hyperion11/CruiseToyotaPradoStm32/README.md

# CruiseToyotaPradoStm32
Cruise control for toyota prado 95
Круиз контроль для TLC Prado 95
