hyperion11/CruiseToyotaPradoStm32/Clip2net_190120225030.png

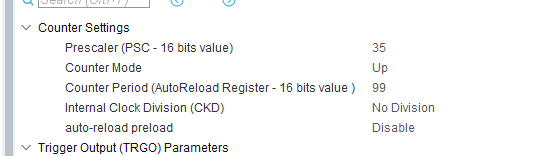
Clip2net_190120225030.png
