hyperion11/CruiseToyotaPradoStm32/bluepill_version_pcb/sch0.1.pdf

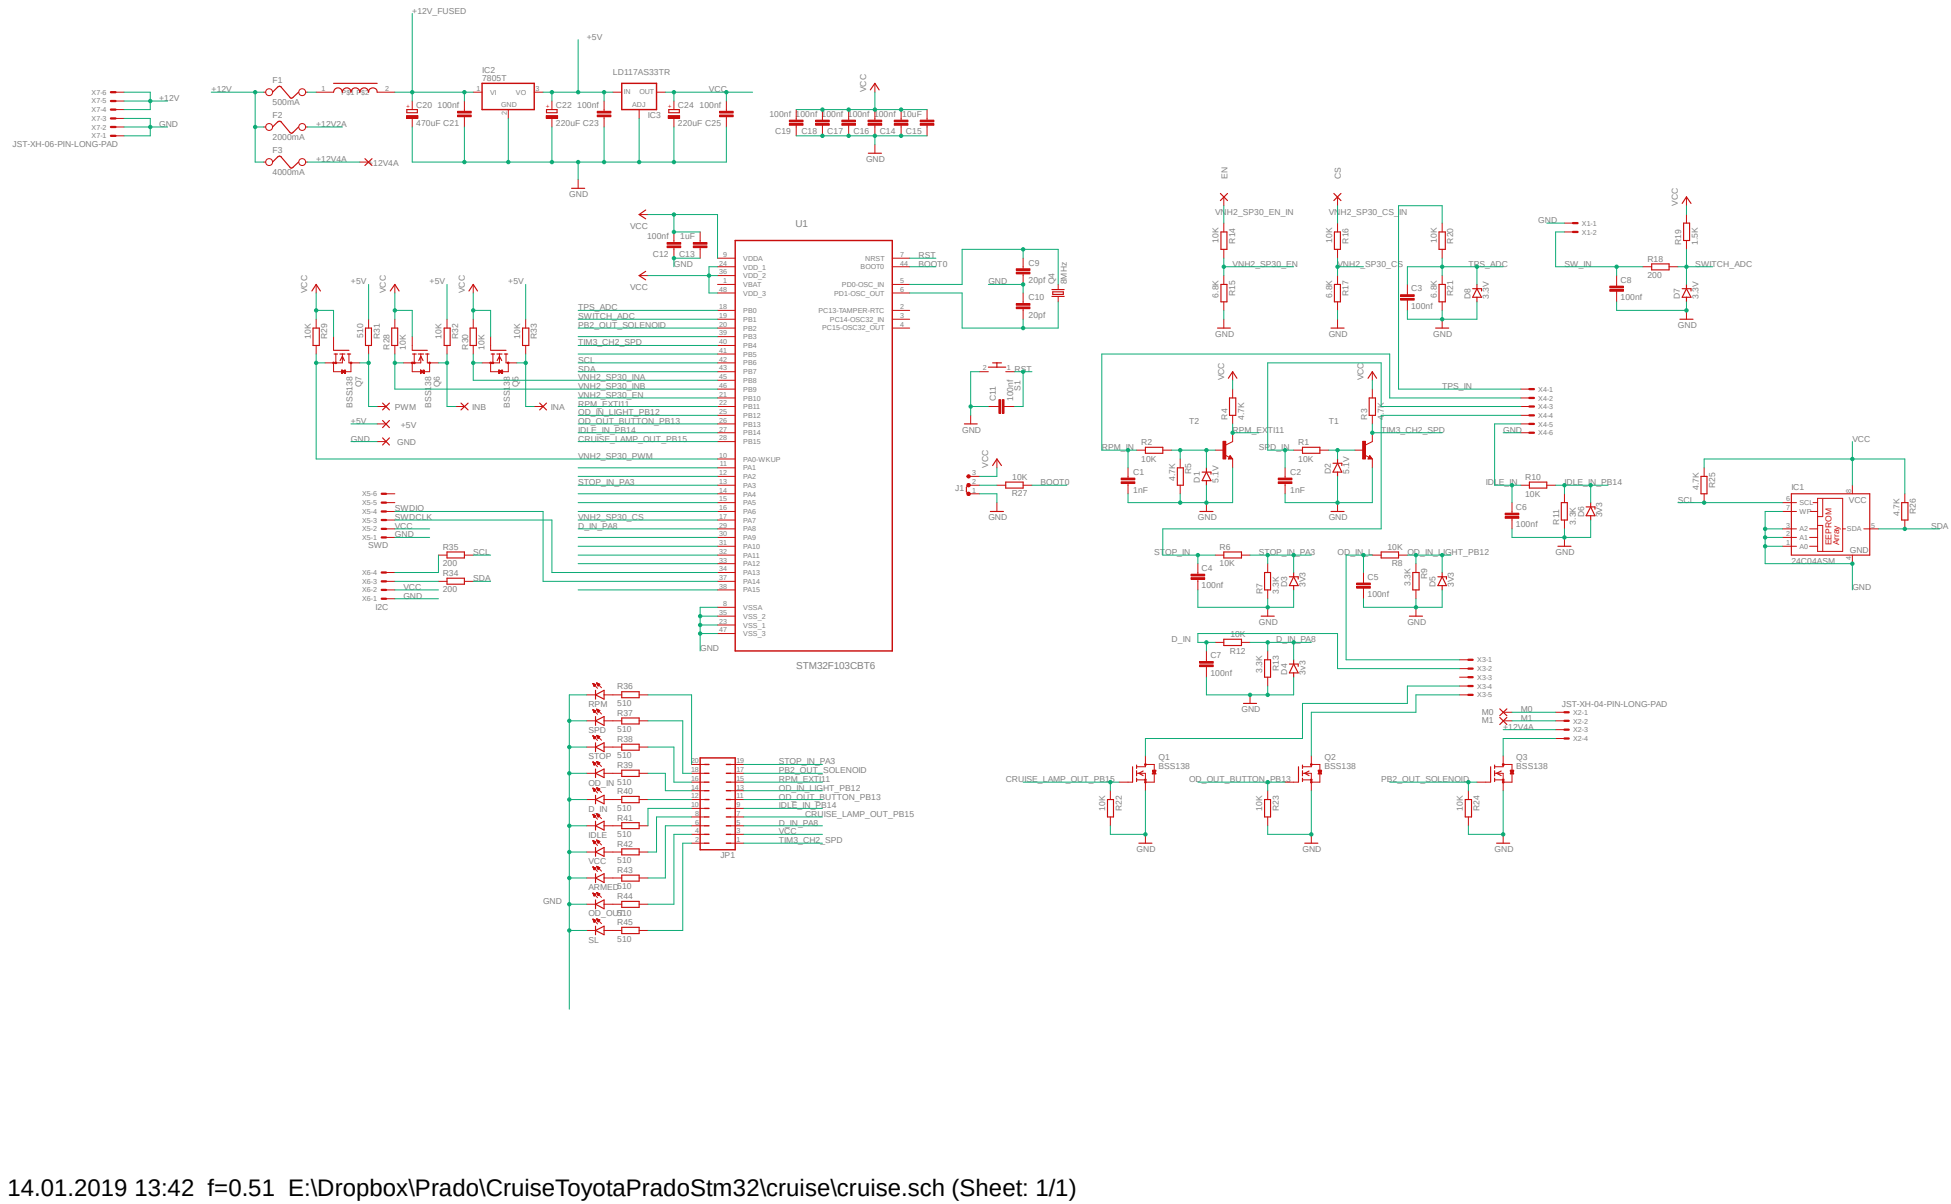
[picture p2: page 1]

JST-XH-06-PIN-LONG-PAD

14.01.2019 13:42 f=0.51 E:\Dropbox\Prado\CruiseToyotaPradoStm32\cruise\cruise.sch (Sheet: 1/1)
