hyperion11/CruiseToyotaPradoStm32/core_version_pcb/cruise.brd

## EAGLE design core_version_pcb/cruise.brd (2019-02-28)

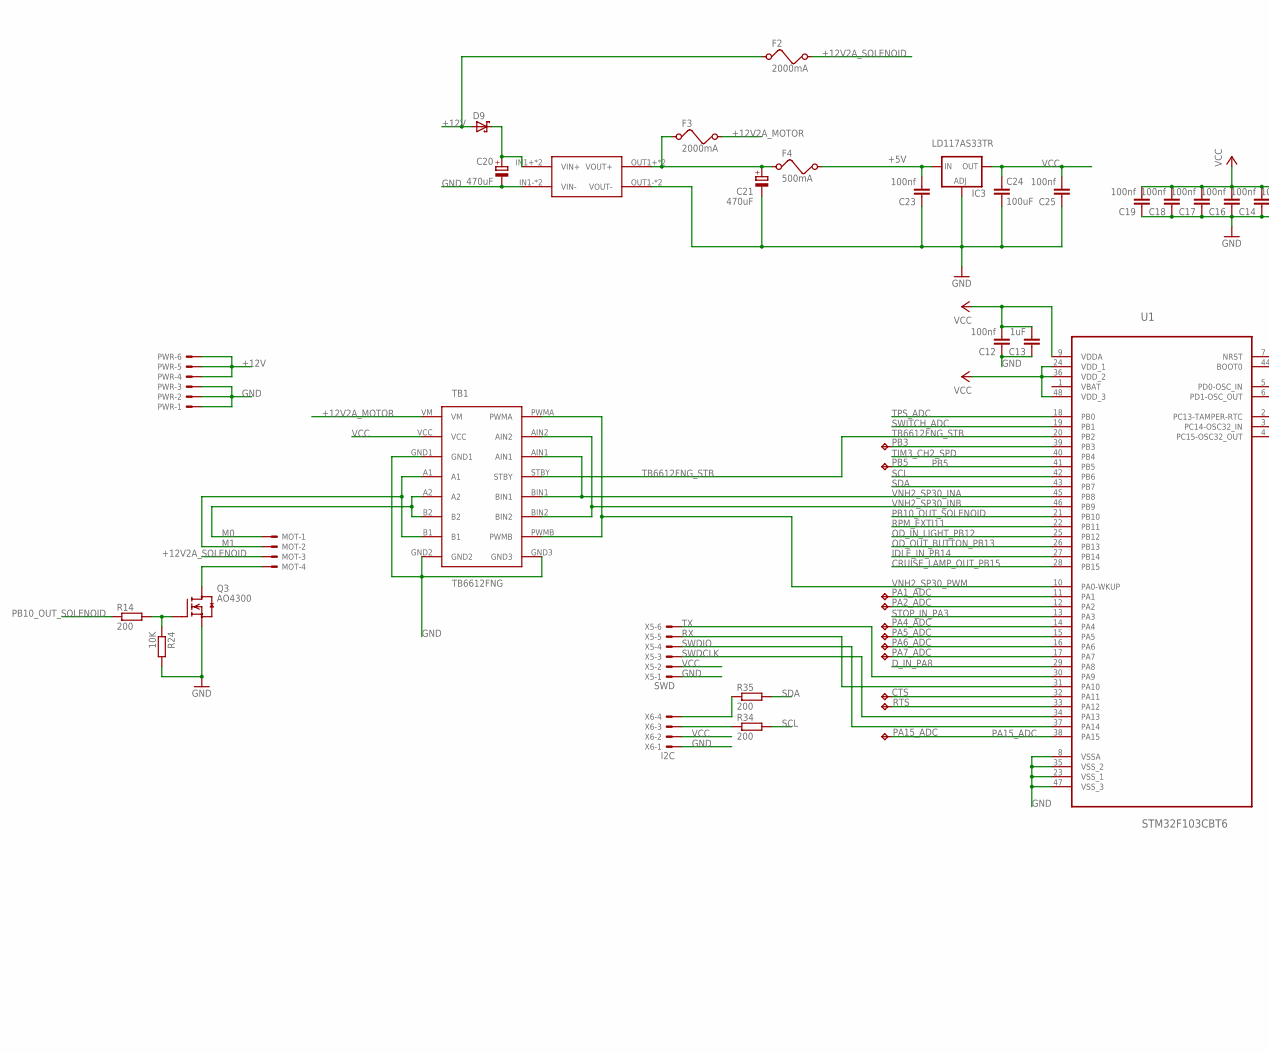
[picture p3: schematic cruise.sch, part in row 1, column 1]

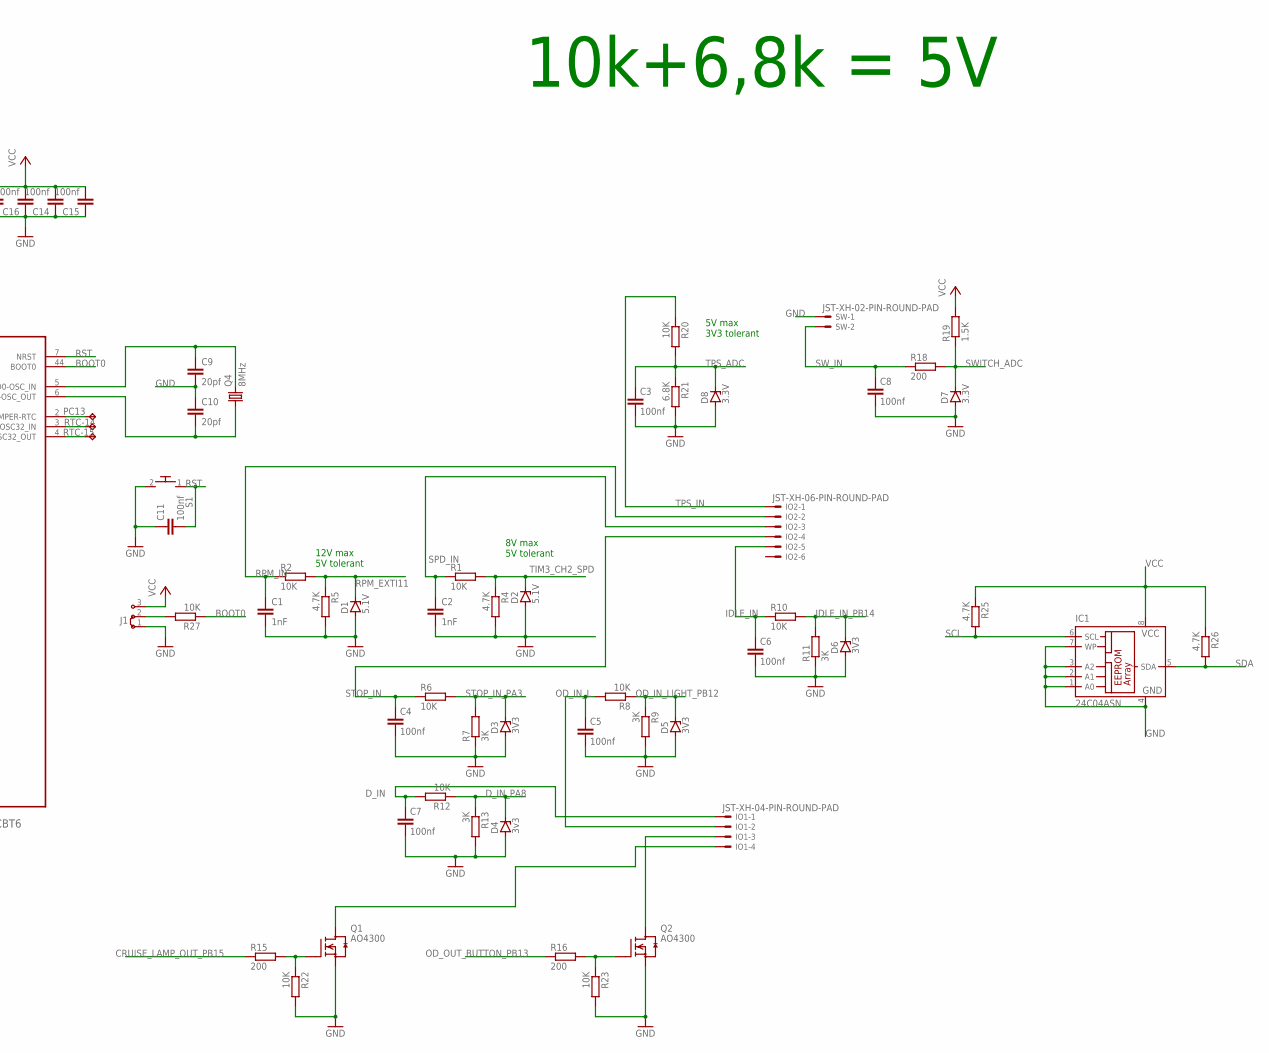
[picture p4: schematic cruise.sch, part in row 1, column 2]

Parts:
C1, C2: 1nF; C0805K
C3, C4, C5, C6, C7, C8, C11, C12, C14, C15, C16, C17, C18, C19: 100nf; C0805K
C9, C10: 20pf; C0603
C13: 1uF; C0805K
C20, C21: 470uF; PANASONIC_G
C23, C25: 100nf; C0805
C24: 100uF; C1210
CTS: TPTP09R; TP09R
D1, D2: 5.1V; SOD80C
D3, D5, D6: 3V3; SOD80C
D4: 3v3; SOD80C
D7, D8: 3.3V; SOD80C
D9: SCHOTTKY-DIODESMC; DIODE_SMC
F2, F3: 2000mA; 1206
F4: 500mA; 1206
IC1: 24C04ASN; SO-08
IC3: LD117AS33TR; SOT223
IO1: JST-XH-04-PIN-ROUND-PAD; JST-XH-04-PACKAGE-ROUND-PAD
IO2: JST-XH-06-PIN-ROUND-PAD; JST-XH-06-PACKAGE-ROUND-PAD
J1: J2X2MM; 04C
MOT: JST-XH-04-PIN-LONG-PAD; JST-XH-04-PACKAGE-LONG-PAD
PA1_ADC, PA2_ADC, PA4_ADC, PA5_ADC, PA6_ADC, PA7_ADC, PA15_ADC: TPTP09R; TP09R
PB3, PB5: TPTP09R; TP09R
PC13: TPTP09R; TP09R
PWR: JST-XH-06-PIN-LONG-PAD; JST-XH-06-PACKAGE-LONG-PAD
Q1, Q2, Q3: AO4300; SOT23
Q4: 8MHz; 5.0X3.2_2
R1, R2, R6, R8, R10, R12, R20, R22, R23, R24, R27: 10K; R0805
R4, R5, R25, R26: 4.7K; R0805
R7, R9, R11, R13: 3K; R0805
R14, R15, R16, R18, R34, R35: 200; R0805
R19: 1.5K; R0805
R21: 6.8K; R0805
RTC-14, RTC-15: TPTP09R; TP09R
RTS: TPTP09R; TP09R
S1: RESET_BUTTON; EVQ-PJU05K
SW: JST-XH-02-PIN-ROUND-PAD; JST-XH-02-PACKAGE-ROUND-PAD
TB1: TB6612FNG
U1: STM32F103CBT6; QFP50P900X900X160-48N
U$6: MP1584; DC-BRICK
X5: SWD; JST-XH-06-PACKAGE-ROUND-PAD
X6: I2C; JST-XH-04-PACKAGE-ROUND-PAD

Connections:
+5V: C23.2, F4.2, IC3.3 (IN)
+12V: D9.A (C), F2.1, PWR.4, PWR.5, PWR.6
+12V2A_MOTOR: F3.2, TB1.VM
+12V2A_SOLENOID: F2.2, MOT.3
BOOT0: R27.1, U1.44 (BOOT0)
CRUISE_LAMP_OUT_PB15: R15.1, U1.28 (PB15)
D_IN: C7.1, IO1.1, R12.2
D_IN_PA8: D4.C, R12.1, R13.1, U1.29 (PA8)
GND: C1.2, C2.2, C3.2, C4.2, C5.2, C6.2, C7.2, C8.2, C9.2, C10.1, C12.1, C13.1, C14.1, C15.1, C16.1, C17.1, C18.1, C19.1, C20.-, C21.-, C23.1, C24.2, C25.1, D1.A, D2.A, D3.A, D4.A, D5.A, D6.A, D7.A, D8.A, IC1.1 (A0), IC1.2 (A1), IC1.3 (A2), IC1.4 (GND), IC1.7 (WP), IC3.1 (ADJ), J1.1, PWR.1, PWR.2, PWR.3, Q1.2 (S), Q2.2 (S), Q3.2 (S), R4.2, R5.2, R7.1, R9.2, R11.1, R13.2, R21.2, R22.2, R23.2, R24.2, SW.1, TB1.GND1, TB1.GND2, TB1.GND3, U1.8 (VSSA), U1.23 (VSS_1), U1.35 (VSS_2), U1.47 (VSS_3), U$6.IN1- (VIN-), U$6.IN2- (VIN-), U$6.OUT1- (VOUT-), U$6.OUT2- (VOUT-), X5.1, X6.1
IDLE_IN: C6.1, IO2.5, R10.1
IDLE_IN_PB14: D6.C, R10.2, R11.2, U1.27 (PB14)
M0: MOT.1, TB1.A2, TB1.B2
M1: MOT.2, TB1.A1, TB1.B1
unnamed: MOT.4, Q3.3 (D)
unnamed: C9.1, Q4.2, U1.5 (PD0-OSC_IN)
unnamed: C10.2, Q4.1, U1.6 (PD1-OSC_OUT)
unnamed: PA7_ADC.TP, U1.17 (PA7)
unnamed: C21.+, F3.1, F4.1, U$6.OUT1+ (VOUT+), U$6.OUT2+ (VOUT+)
unnamed: PB3.TP, U1.39 (PB3)
unnamed: J1.2, R27.2
unnamed: Q3.1 (G), R14.2, R24.1
unnamed: C11.1, S1.2
unnamed: Q1.1 (G), R15.2, R22.1
unnamed: R34.1, X6.3
unnamed: R35.1, X6.4
unnamed: Q2.1 (G), R16.2, R23.1
unnamed: PC13.TP, U1.2 (PC13-TAMPER-RTC)
unnamed: RTC-14.TP, U1.3 (PC14-OSC32_IN)
unnamed: RTC-15.TP, U1.4 (PC15-OSC32_OUT)
unnamed: C20.+, D9.C (A), U$6.IN1+ (VIN+), U$6.IN2+ (VIN+)
unnamed: PA1_ADC.TP, U1.11 (PA1)
unnamed: PA2_ADC.TP, U1.12 (PA2)
unnamed: PA4_ADC.TP, U1.14 (PA4)
unnamed: PA6_ADC.TP, U1.16 (PA6)
unnamed: PA5_ADC.TP, U1.15 (PA5)
unnamed: IO1.4, Q1.3 (D)
unnamed: IO1.3, Q2.3 (D)
unnamed: CTS.TP, U1.32 (PA11)
unnamed: RTS.TP, U1.33 (PA12)
OD_IN_L: C5.1, IO1.2, R8.2
OD_IN_LIGHT_PB12: D5.C, R8.1, R9.1, U1.25 (PB12)
OD_OUT_BUTTON_PB13: R16.1, U1.26 (PB13)
PA15_ADC: PA15_ADC.TP, U1.38 (PA15)
PB5: PB5.TP, U1.41 (PB5)
PB10_OUT_SOLENOID: R14.1, U1.21 (PB10)
RPM_EXTI11: D1.C, R2.2, R5.1, U1.22 (PB11)
RPM_IN: C1.1, IO2.2, R2.1
RST: C11.2, S1.1, U1.7 (NRST)
RX: U1.31 (PA10), X5.5
SCL: IC1.6 (SCL), R25.2, R34.2, U1.42 (PB6)
SDA: IC1.5 (SDA), R26.2, R35.2, U1.43 (PB7)
SPD_IN: C2.1, IO2.3, R1.1
STOP_IN: C4.1, IO2.4, R6.1
STOP_IN_PA3: D3.C, R6.2, R7.2, U1.13 (PA3)
SWDCLK: U1.37 (PA14), X5.4
SWDIO: U1.34 (PA13), X5.3
SWITCH_ADC: D7.C, R18.2, R19.1, U1.19 (PB1)
SW_IN: C8.1, R18.1, SW.2
TB6612FNG_STB: TB1.STBY, U1.20 (PB2)
TIM3_CH2_SPD: D2.C, R1.2, R4.1, U1.40 (PB4)
TPS_ADC: C3.1, D8.C, R20.2, R21.1, U1.18 (PB0)
TPS_IN: IO2.1, R20.1
TX: U1.30 (PA9), X5.6
VCC: C12.2, C13.2, C14.2, C15.2, C16.2, C17.2, C18.2, C19.2, C24.1, C25.2, IC1.8 (VCC), IC3.4 (OUT), J1.3, R19.2, R25.1, R26.1, TB1.VCC, U1.9 (VDDA), U1.24 (VDD_1), U1.36 (VDD_2), U1.48 (VDD_3), X5.2, X6.2
VNH2_SP30_INA: TB1.AIN1, TB1.BIN1, U1.45 (PB8)
VNH2_SP30_INB: TB1.AIN2, TB1.BIN2, U1.46 (PB9)
VNH2_SP30_PWM: TB1.PWMA, TB1.PWMB, U1.10 (PA0-WKUP)

Notes on the sheet:
10k+6,8k = 5V
8V max 5V tolerant
12V max 5V tolerant
5V max 3V3 tolerant

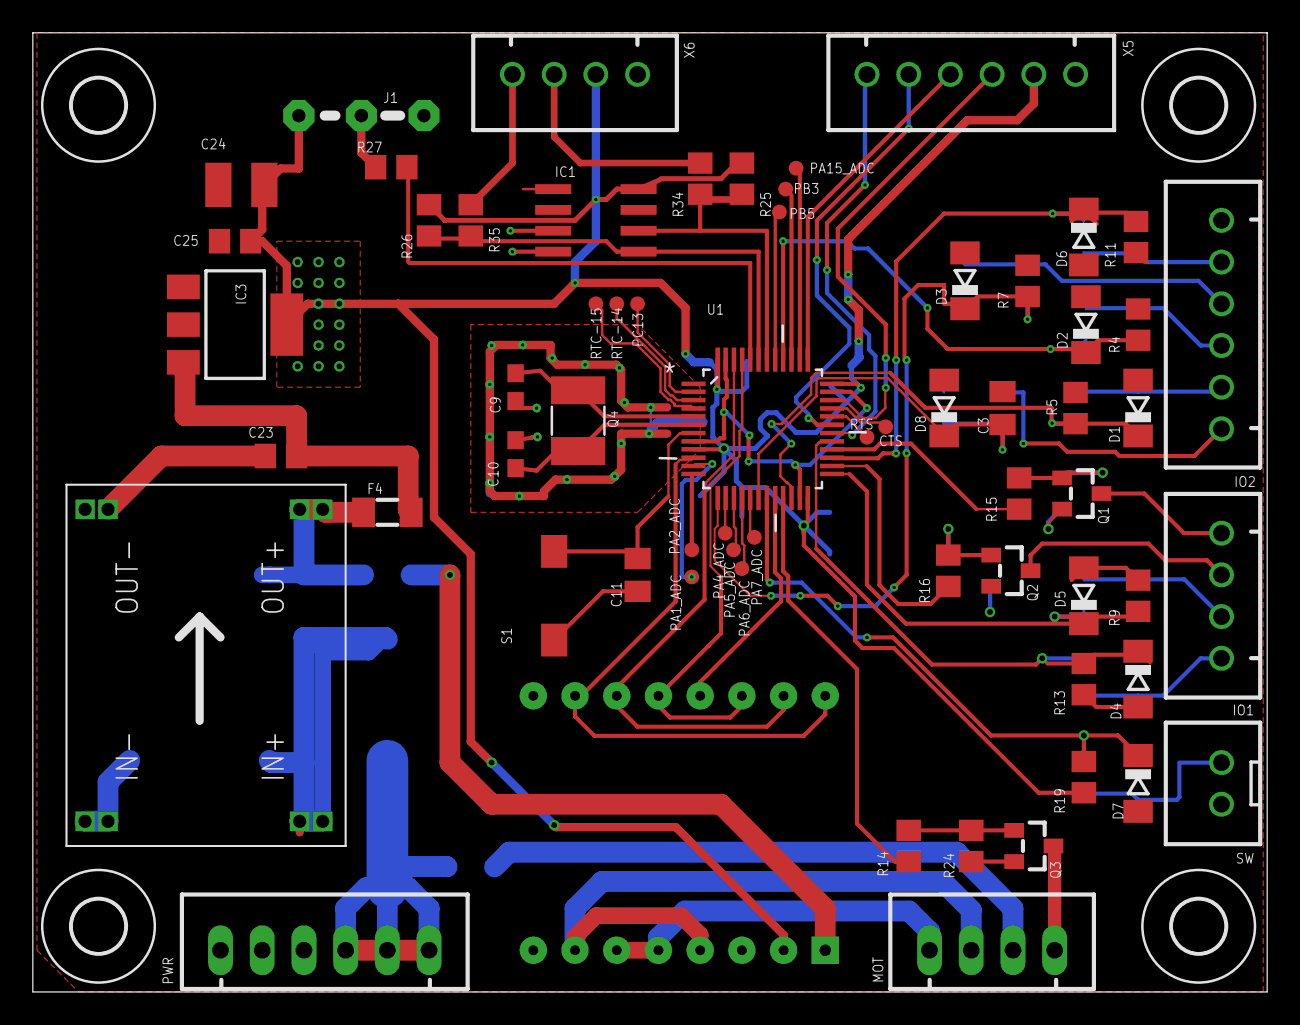
[picture p5: board core_version_pcb/cruise.brd from above]

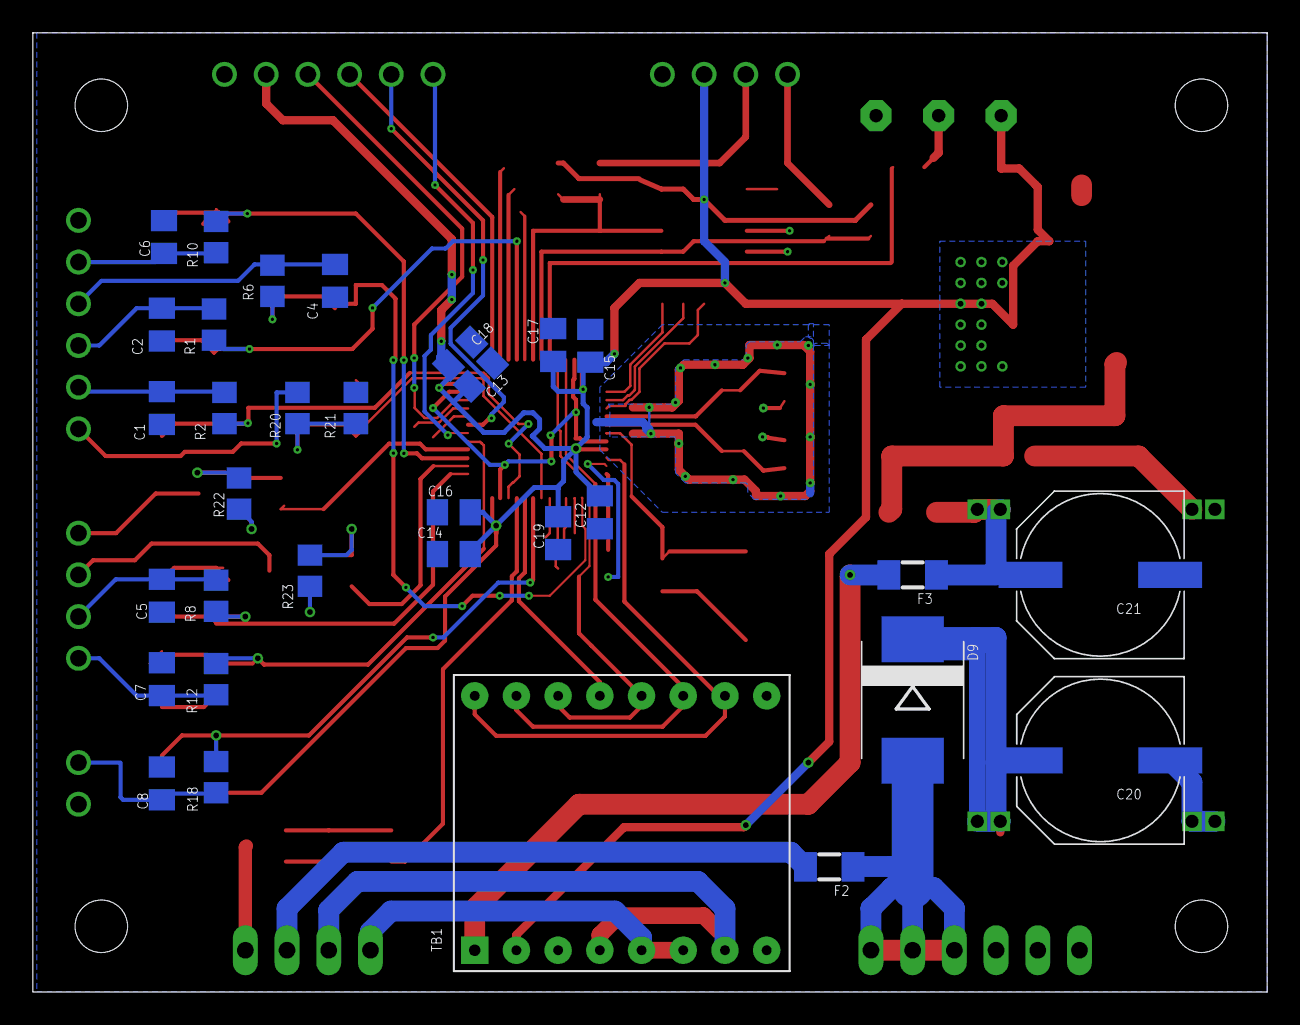
[picture p6: board core_version_pcb/cruise.brd from below]

Board: 2 copper layers, 75.2 x 58.4 mm, 99 parts (32 on the bottom side), 67 nets.

Other parts of the board:
U$2, U$3, U$4, U$5: 3,2
