hyperion11/CruiseToyotaPradoStm32/bluepill_version_pcb/cruise.brd

## EAGLE design bluepill_version_pcb/cruise.brd (2019-04-12)

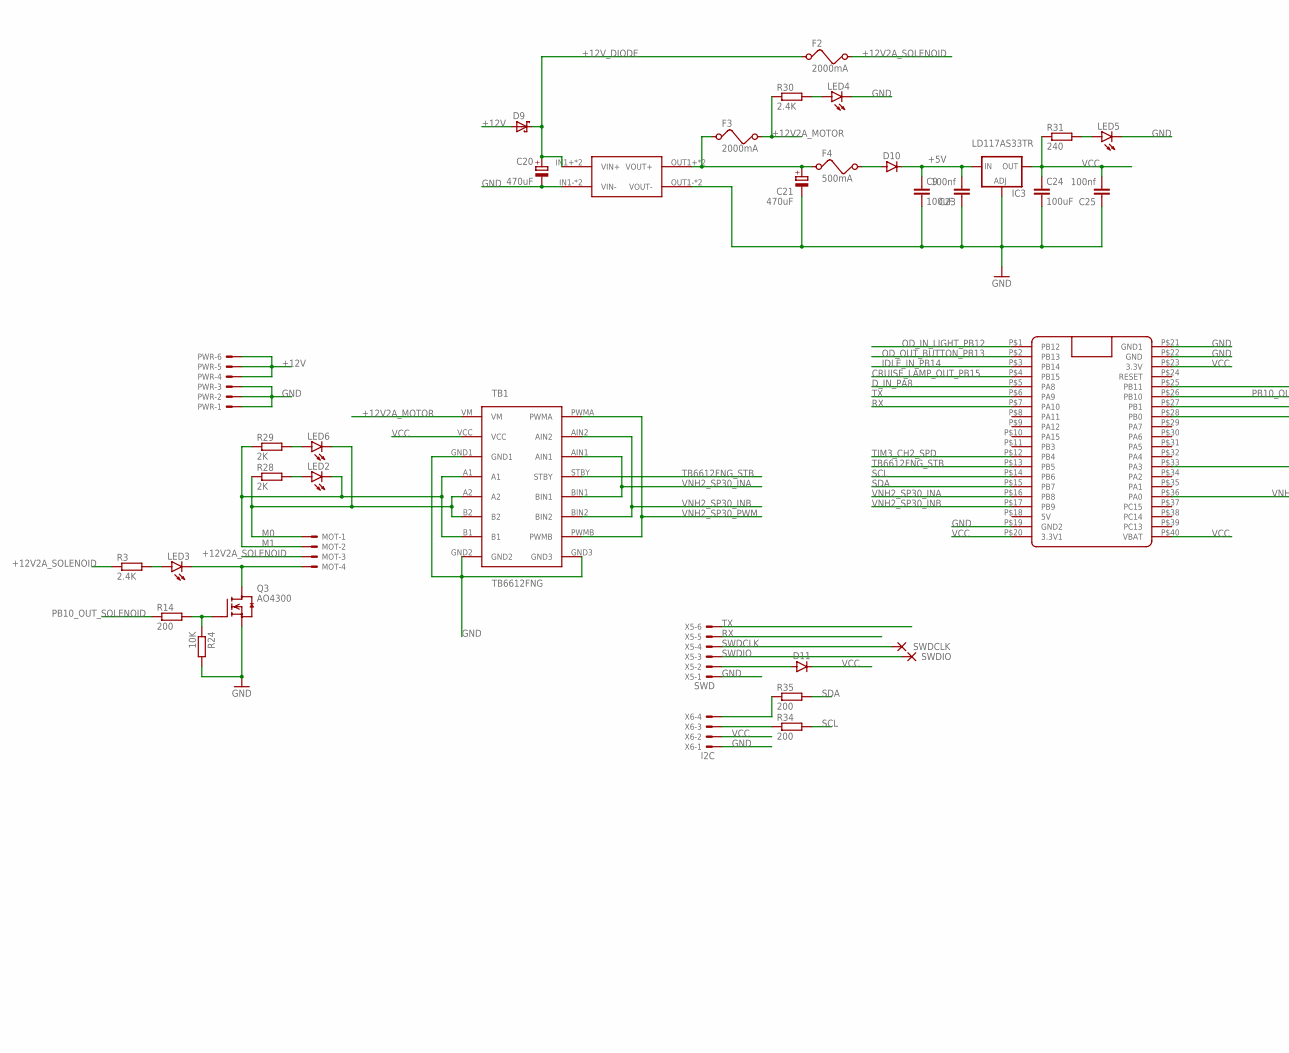
[picture p7: schematic cruise.sch, part in row 1, column 1]

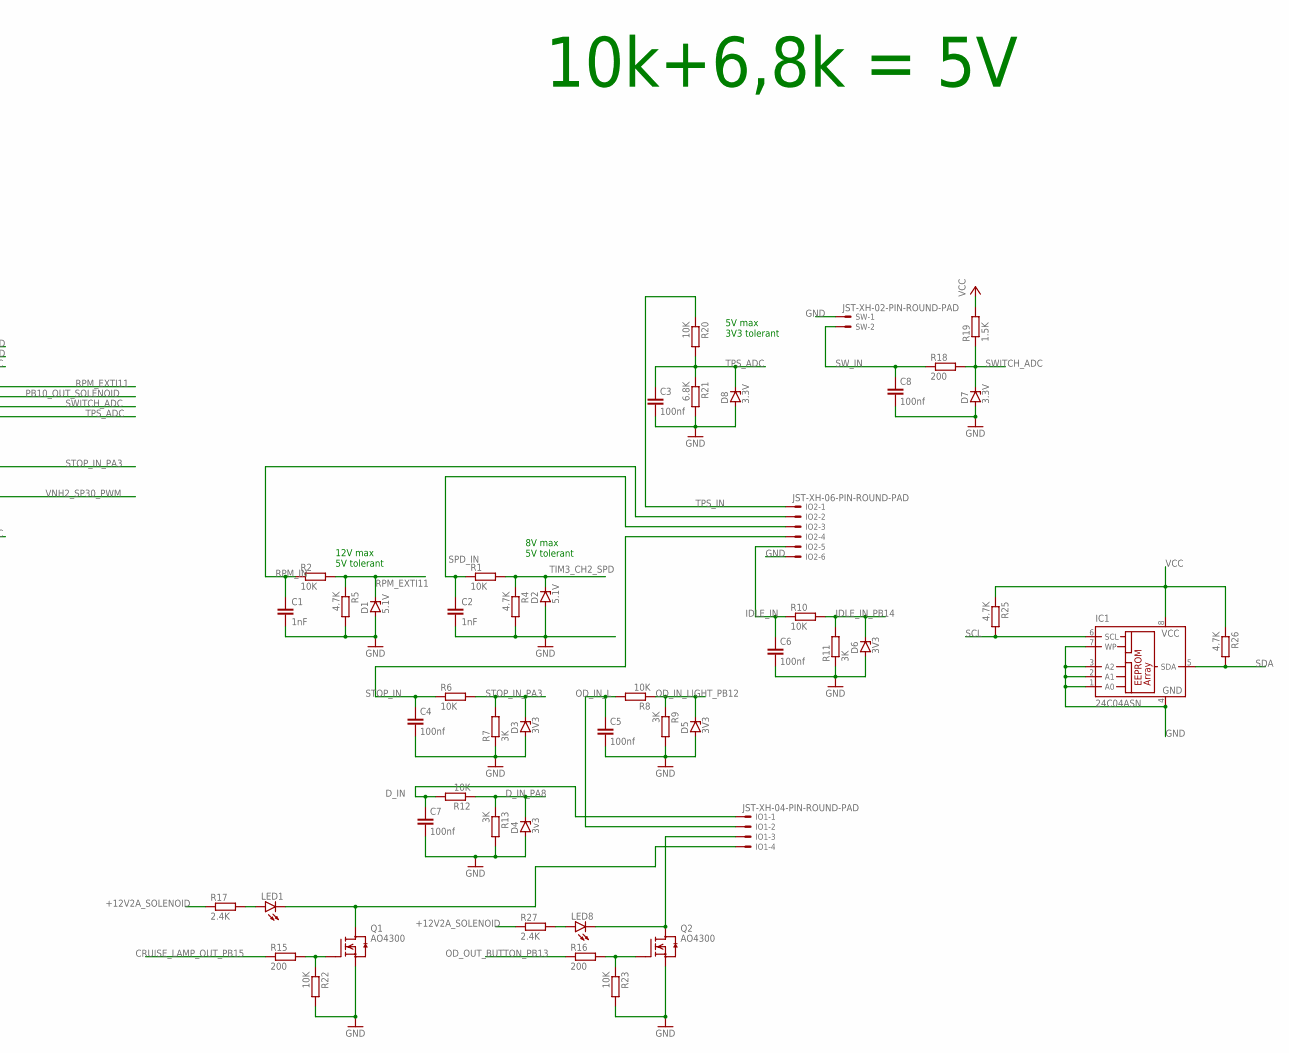
[picture p8: schematic cruise.sch, part in row 1, column 2]

Parts:
C1, C2: 1nF; C0805K
C3, C4, C5, C6, C7, C8: 100nf; C0805K
C9, C24: 100uF; C1210
C20, C21: 470uF; PANASONIC_G
C23, C25: 100nf; C0805
D1, D2: 5.1V; SOD80C
D3, D5, D6: 3V3; SOD80C
D4: 3v3; SOD80C
D7, D8: 3.3V; SOD80C
D9: SCHOTTKY-DIODESMC; DIODE_SMC
D10, D11: DIODE-SOD323-W; SOD323-W
F2, F3: 2000mA; 1206
F4: 500mA; 1206
IC1: 24C04ASN; SO-08
IC3: LD117AS33TR; SOT223
IO1: JST-XH-04-PIN-ROUND-PAD; JST-XH-04-PACKAGE-ROUND-PAD
IO2: JST-XH-06-PIN-ROUND-PAD; JST-XH-06-PACKAGE-ROUND-PAD
LED1, LED2, LED3, LED4, LED5, LED6, LED8: LED3MM
MOT: JST-XH-04-PIN-LONG-PAD; JST-XH-04-PACKAGE-LONG-PAD
PWR: JST-XH-06-PIN-LONG-PAD; JST-XH-06-PACKAGE-LONG-PAD
Q1, Q2, Q3: AO4300; SOT23
R1, R2, R6, R8, R10, R12, R20, R22, R23, R24: 10K; R0805
R3, R17, R27, R30: 2.4K; R0805
R4, R5, R25, R26: 4.7K; R0805
R7, R9, R11, R13: 3K; R0805
R14, R15, R16, R18, R34, R35: 200; R0805
R19: 1.5K; R0805
R21: 6.8K; R0805
R28, R29: 2K; R0805
R31: 240; R0805
SW: JST-XH-02-PIN-ROUND-PAD; JST-XH-02-PACKAGE-ROUND-PAD
SWDCLK: WIREPAD2,15/1,0; 2,15/1,0
SWDIO: WIREPAD2,15/1,0; 2,15/1,0
TB1: TB6612FNG
U$1: BLUE_PILL
U$6: MP1584; DC-BRICK
X5: SWD; JST-XH-06-PACKAGE-ROUND-PAD
X6: I2C; JST-XH-04-PACKAGE-ROUND-PAD

Connections:
+5V: C9.1, C23.2, D10.C, IC3.3 (IN)
+12V: D9.A (C), PWR.4, PWR.5, PWR.6
+12V2A_MOTOR: F3.2, R30.1, TB1.VM
+12V2A_SOLENOID: F2.2, MOT.3, R3.1, R17.1, R27.1
+12V_DIODE: C20.+, D9.C (A), F2.1, U$6.IN1+ (VIN+), U$6.IN2+ (VIN+)
CRUISE_LAMP_OUT_PB15: R15.1, U$1.P$4 (PB15)
D_IN: C7.1, IO1.1, R12.2
D_IN_PA8: D4.C, R12.1, R13.1, U$1.P$5 (PA8)
GND: C1.2, C2.2, C3.2, C4.2, C5.2, C6.2, C7.2, C8.2, C9.2, C20.-, C21.-, C23.1, C24.2, C25.1, D1.A, D2.A, D3.A, D4.A, D5.A, D6.A, D7.A, D8.A, IC1.1 (A0), IC1.2 (A1), IC1.3 (A2), IC1.4 (GND), IC1.7 (WP), IC3.1 (ADJ), IO2.6, LED4.K (C), LED5.K (C), PWR.1, PWR.2, PWR.3, Q1.2 (S), Q2.2 (S), Q3.2 (S), R4.2, R5.2, R7.1, R9.2, R11.1, R13.2, R21.2, R22.2, R23.2, R24.2, SW.1, TB1.GND1, TB1.GND2, TB1.GND3, U$1.P$19 (GND2), U$1.P$21 (GND1), U$1.P$22 (GND), U$6.IN1- (VIN-), U$6.IN2- (VIN-), U$6.OUT1- (VOUT-), U$6.OUT2- (VOUT-), X5.1, X6.1
IDLE_IN: C6.1, IO2.5, R10.1
IDLE_IN_PB14: D6.C, R10.2, R11.2, U$1.P$3 (PB14)
M0: LED6.K (C), MOT.1, R28.1, TB1.A2, TB1.B2
M1: LED2.K (C), MOT.2, R29.1, TB1.A1, TB1.B1
unnamed: LED1.A, R17.2
unnamed: D10.A, F4.2
unnamed: D11.A, X5.2
unnamed: LED3.A, R3.2
unnamed: C21.+, F3.1, F4.1, U$6.OUT1+ (VOUT+), U$6.OUT2+ (VOUT+)
unnamed: LED3.K (C), MOT.4, Q3.3 (D)
unnamed: LED2.A, R28.2
unnamed: Q3.1 (G), R14.2, R24.1
unnamed: LED8.A, R27.2
unnamed: Q1.1 (G), R15.2, R22.1
unnamed: R34.1, X6.3
unnamed: R35.1, X6.4
unnamed: LED6.A, R29.2
unnamed: Q2.1 (G), R16.2, R23.1
unnamed: LED4.A, R30.2
unnamed: LED5.A, R31.2
unnamed: IO1.4, LED1.K (C), Q1.3 (D)
unnamed: IO1.3, LED8.K (C), Q2.3 (D)
OD_IN_L: C5.1, IO1.2, R8.2
OD_IN_LIGHT_PB12: D5.C, R8.1, R9.1, U$1.P$1 (PB12)
OD_OUT_BUTTON_PB13: R16.1, U$1.P$2 (PB13)
PB10_OUT_SOLENOID: R14.1, U$1.P$26 (PB10)
RPM_EXTI11: D1.C, R2.2, R5.1, U$1.P$25 (PB11)
RPM_IN: C1.1, IO2.2, R2.1
RX: U$1.P$7 (PA10), X5.5
SCL: IC1.6 (SCL), R25.2, R34.2, U$1.P$14 (PB6)
SDA: IC1.5 (SDA), R26.2, R35.2, U$1.P$15 (PB7)
SPD_IN: C2.1, IO2.3, R1.1
STOP_IN: C4.1, IO2.4, R6.1
STOP_IN_PA3: D3.C, R6.2, R7.2, U$1.P$33 (PA3)
SWDCLK: SWDCLK.1, X5.4
SWDIO: SWDIO.1, X5.3
SWITCH_ADC: D7.C, R18.2, R19.1, U$1.P$27 (PB1)
SW_IN: C8.1, R18.1, SW.2
TB6612FNG_STB: TB1.STBY, U$1.P$13 (PB5)
TIM3_CH2_SPD: D2.C, R1.2, R4.1, U$1.P$12 (PB4)
TPS_ADC: C3.1, D8.C, R20.2, R21.1, U$1.P$28 (PB0)
TPS_IN: IO2.1, R20.1
TX: U$1.P$6 (PA9), X5.6
VCC: C24.1, C25.2, D11.C, IC1.8 (VCC), IC3.4 (OUT), R19.2, R25.1, R26.1, R31.1, TB1.VCC, U$1.P$20 (3.3V1), U$1.P$23 (3.3V), U$1.P$40 (VBAT), X6.2
VNH2_SP30_INA: TB1.AIN1, TB1.BIN1, U$1.P$16 (PB8)
VNH2_SP30_INB: TB1.AIN2, TB1.BIN2, U$1.P$17 (PB9)
VNH2_SP30_PWM: TB1.PWMA, TB1.PWMB, U$1.P$36 (PA0)

Notes on the sheet:
10k+6,8k = 5V
8V max 5V tolerant
12V max 5V tolerant
5V max 3V3 tolerant

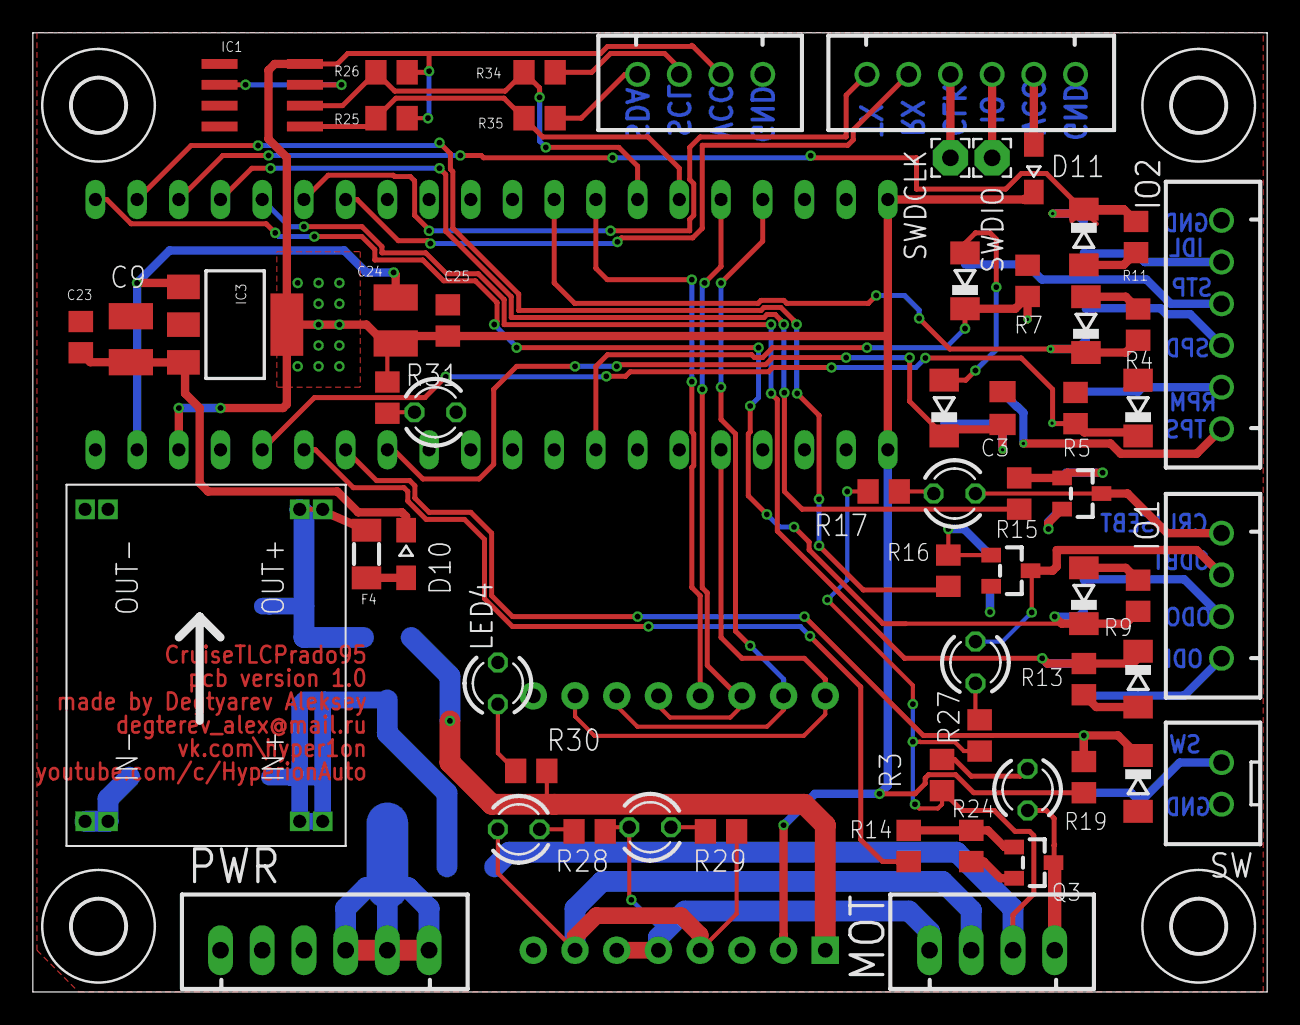
[picture p9: board bluepill_version_pcb/cruise.brd from above]

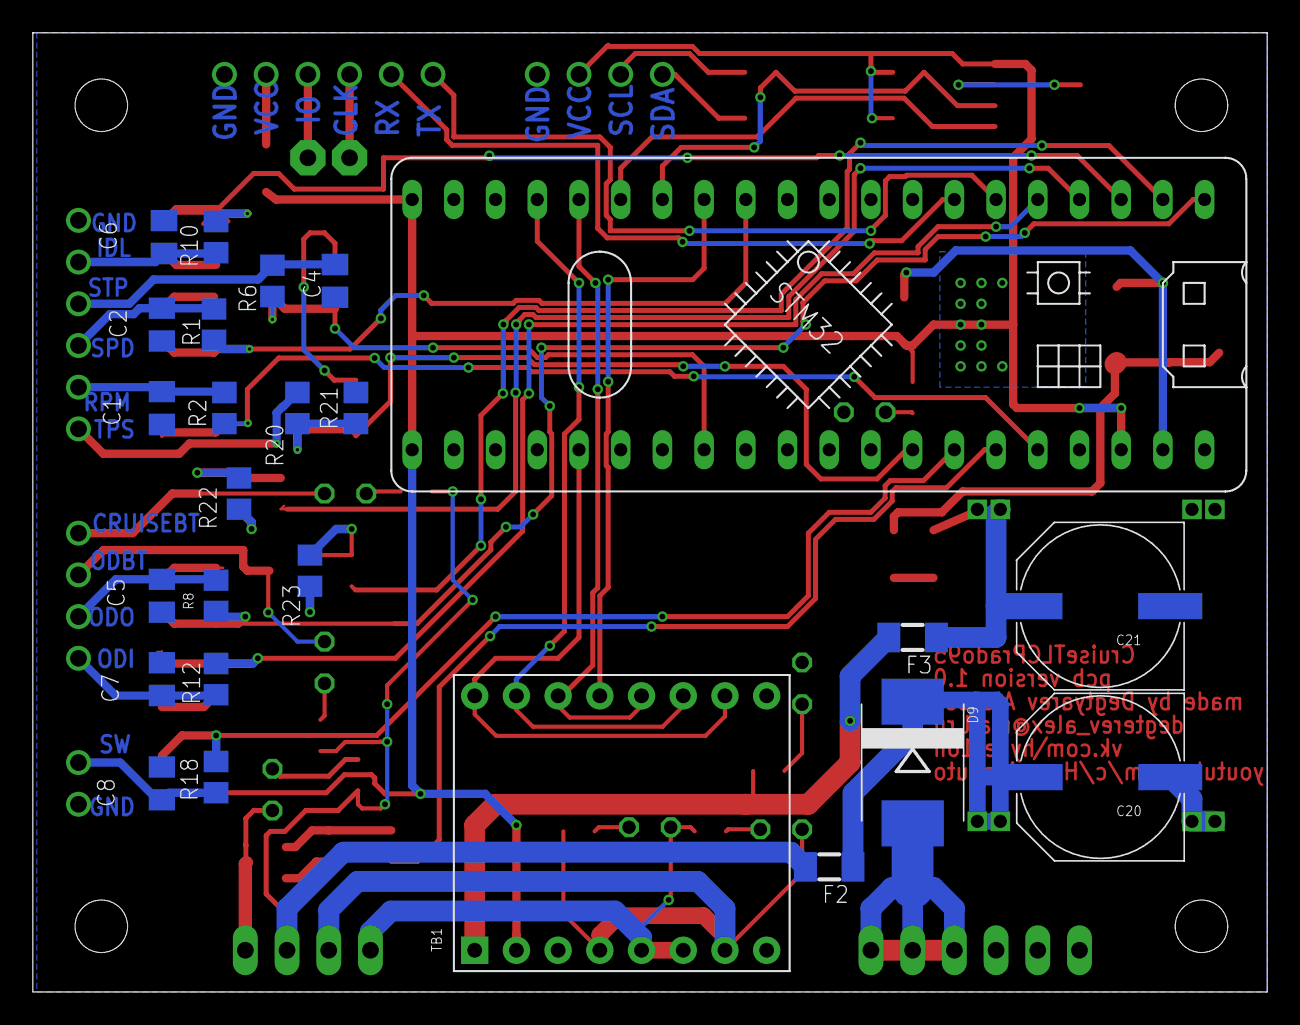
[picture p10: board bluepill_version_pcb/cruise.brd from below]

Board: 2 copper layers, 75.2 x 58.4 mm, 89 parts (25 on the bottom side), 56 nets.

Other parts of the board:
U$2, U$3, U$4, U$5: 3,2
