hyperion11/CruiseToyotaPradoStm32/STM32CubeMX/Src/main.c

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

/* Includes ------------------------------------------------------------------*/
#include "main.h"

/* USER CODE BEGIN Includes */
#include "u8g2\u8g2.h"
#include "stdbool.h"
#include "arm_math.h"
#include "stdlib.h"
#include "ftoa.h"
/* USER CODE END Includes */

/* USER CODE BEGIN PD */
#define EEPROM_BLOCK_SIZE 32
#define TPS_Data 0
#define Switch_Data 1
#define CCV 0
#define CV 1
#define font_w 9
#define font_h 8
#define LONG_PRESS_DURATION 20 //20x100ms-100мс время опроса рычага. 2секунды на распознание долгого нажания
enum ACTION {
	UP, DOWN
};
enum EDITED_VALUE {
	PID_P, PID_I, PID_D
};
uint8_t EDITED_VALUE_NUM = 0;

/* USER CODE END PD */

ADC_HandleTypeDef hadc1;

I2C_HandleTypeDef hi2c1;

TIM_HandleTypeDef htim1;
TIM_HandleTypeDef htim2;
TIM_HandleTypeDef htim3;

/* USER CODE BEGIN PV */
volatile uint16_t ticktock = 0;
volatile uint16_t ADC_Data[2]; //0-TPS CH8;;;; 1-Switch CH9 ;;;;
volatile uint8_t OldKeyValue = 5; // Состояние покоя
volatile int s = 0;
volatile bool dir_current, dir_previous;
volatile uint16_t rpm_ticks = 0, rpm = 0;
volatile uint16_t second;
volatile uint8_t NewKeyValue = 5;
const uint16_t values[5] = { 0, 366, 825, 1367, 2117 };
const uint8_t error = 65;       // Величина отклонения от значений - погрешность
static u8g2_t u8g2;
uint32_t amountsent = 0;
bool EEPROM_RECENT_WRITE = false;
volatile uint32_t IC_Faling_Val; // Direct mode	Faling Edge Detection
volatile uint32_t SPD_Pulse_width;
volatile bool lowspeed = true;
volatile bool pidloop;
uint8_t detectlongpress[4];
float spd;
arm_pid_instance_f32 PID;
int32_t pwm = 0;
volatile float pid_error;
struct EESTR {
	float PID_P;
	float PID_I;
	float PID_D;
////
} EEPROM;

//float PID_P = 100, PID_I = 0.025, PID_D = 10;
//float pid_error;
float SPD_CURRENT, SPD_TARGET;
int32_t PID_OUT_CURRENT, PID_OUT_PREVIOUS;
bool CRUISE_ARMED = false, STP = false, AT_OD = false, IDLE = true,
		AT_D = false;
volatile uint8_t screen = 1;
uint8_t activescreen = 0;
const uint16_t devAddr = (0x50 << 1); // HAL expects address to be shifted one bit to the left
//const uint16_t memAddrP = 0;
//const uint16_t memAddrI = 0 + sizeof(PID_P);
//const uint16_t memAddrD = 0 + sizeof(PID_P) + sizeof(PID_I);

/* USER CODE END PV */

void SystemClock_Config(void);
static void MX_GPIO_Init(void);
static void MX_ADC1_Init(void);
static void MX_TIM1_Init(void);
static void MX_TIM2_Init(void);
static void MX_I2C1_Init(void);
static void MX_TIM3_Init(void);
/* USER CODE BEGIN 0 */
void SaveToEEPROM() {
	if (!EEPROM_RECENT_WRITE) {
		EEPROM.PID_P = PID.Kp;
		EEPROM.PID_I = PID.Ki;
		EEPROM.PID_D = PID.Kd;
		uint8_t * p = (uint8_t *) &EEPROM;
		//uint8_t const * p = (uint8_t const *) &EEPROM;
		for (size_t i = 0, len = sizeof(EEPROM); i < sizeof(EEPROM); i +=
		EEPROM_BLOCK_SIZE, len -= EEPROM_BLOCK_SIZE) {
			HAL_I2C_Mem_Write(&hi2c1, devAddr, i, I2C_MEMADD_SIZE_16BIT, p + i,
					(len > EEPROM_BLOCK_SIZE) ? EEPROM_BLOCK_SIZE : len, 1);

		}
		EEPROM_RECENT_WRITE = true;
	}
}

void setMSpeed(int32_t duty) {
	if (duty < 0) {
		duty = -duty;  // Make speed a positive quantity
		dir_current = CCV;  // Preserve the direction
	} else
		dir_current = CV;
	if (duty > 899)  // Max PWM dutycycle
		duty = 899;
	if (duty < 50)
		duty = 0; //меньше 50 нет вращения мотора
	TIM2->CCR1 = duty;
	if (duty == 0) {
		HAL_GPIO_WritePin(VNH2_SP30_INB_GPIO_Port, VNH2_SP30_INA_Pin,
				GPIO_PIN_RESET);
		HAL_GPIO_WritePin(VNH2_SP30_INA_GPIO_Port, VNH2_SP30_INB_Pin,
				GPIO_PIN_RESET);
	} else if (dir_current == CV) {
		//пауза в случае реверса мотора
	//	if (dir_current != dir_previous) {
		//	HAL_Delay(50);
	//		dir_previous = dir_current;
	//	}
		HAL_GPIO_WritePin(VNH2_SP30_INA_GPIO_Port, VNH2_SP30_INA_Pin,
				GPIO_PIN_SET);
		HAL_GPIO_WritePin(VNH2_SP30_INB_GPIO_Port, VNH2_SP30_INB_Pin,
				GPIO_PIN_RESET);
	} else if (dir_current == CCV) {
		//if (dir_current != dir_previous) {
		//	HAL_Delay(50);
		//	dir_previous = dir_current;
		//}
		HAL_GPIO_WritePin(VNH2_SP30_INA_GPIO_Port, VNH2_SP30_INA_Pin,
				GPIO_PIN_RESET);
		HAL_GPIO_WritePin(VNH2_SP30_INB_GPIO_Port, VNH2_SP30_INB_Pin,
				GPIO_PIN_SET);
	}
}

void disarm(void) {
	CRUISE_ARMED = false;
	//отключение магнитной муфты
	HAL_GPIO_WritePin(GPIOB, PB10_OUT_SOLENOID_Pin, GPIO_PIN_RESET);
	//отключение индикатора круиза
	HAL_GPIO_WritePin(GPIOB, CRUISE_LAMP_OUT_PB15_Pin, GPIO_PIN_RESET);
	HAL_GPIO_WritePin(GPIOB, TB6612FNG_STB_Pin, GPIO_PIN_RESET);
	//останов привода круиза
	setMSpeed(0);
	arm_pid_reset_f32(&PID);

}

void CheckCruiseAndDisarm(bool STP_Status, bool AT_D_Status,
bool IDLE_Status, uint16_t RPM_Status, float SPD_Status) {
	//if (CRUISE_ARMED == true)
	//if (STP_Status == true || AT_D_Status == false || IDLE_Status == true	|| RPM_Status > 3500 || SPD_Status > 130.0 || SPD_Status < 40.0)
	//disarm();
}

void arm() {
	SPD_TARGET = (int) SPD_CURRENT + 0.1;
	CRUISE_ARMED = true;
	//включение магнитной муфты
	HAL_GPIO_WritePin(GPIOB, PB10_OUT_SOLENOID_Pin, GPIO_PIN_SET);
	//включение индикатора круиза
	HAL_GPIO_WritePin(GPIOB, CRUISE_LAMP_OUT_PB15_Pin, GPIO_PIN_SET);
	HAL_GPIO_WritePin(GPIOB, TB6612FNG_STB_Pin, GPIO_PIN_SET);
	CheckCruiseAndDisarm(STP, AT_D, IDLE, rpm, SPD_CURRENT);
}

uint8_t GetButtonNumberByValue(uint16_t value) { // Новая функция по преобразованию кода нажатой кнопки в её номер
	for (uint8_t i = 0; i <= 4; i++) {
		// Если значение в заданном диапазоне values[i]+/-error - считаем, что кнопка определена
		if (value <= values[i] + error && value >= values[i] - error)
			return i;
	}
	return 5;                 // Значение не принадлежит заданному диапазону
}

void readADC() {
	HAL_ADCEx_InjectedStart(&hadc1);
	HAL_ADC_PollForConversion(&hadc1, 100);
	ADC_Data[TPS_Data] = HAL_ADCEx_InjectedGetValue(&hadc1,
	ADC_INJECTED_RANK_1);
	ADC_Data[Switch_Data] = HAL_ADCEx_InjectedGetValue(&hadc1,
	ADC_INJECTED_RANK_2);
	HAL_ADCEx_InjectedStop(&hadc1);
}

void readGPIO() {
	if (HAL_GPIO_ReadPin(GPIOA, STOP_IN_PA3_Pin) == GPIO_PIN_SET)
		//Обработка нажания на педаль тормоза. Нажата - высокий уровень. Отпущена - низкий
		STP = true;
	else
		STP = false;
	if (HAL_GPIO_ReadPin(GPIOA, D_IN_PA8_Pin) == GPIO_PIN_SET)
		//Обработка селектора АКПП. Селектор в положении D - высокий уровень. В любом другом - низкий
		AT_D = true;
	else
		AT_D = false;
	if (HAL_GPIO_ReadPin(GPIOB, IDLE_IN_PB14_Pin) == GPIO_PIN_SET)
		//Обработка ХХ. Дроссель полностью закрыт - низкий урове. Приоткрыта - высокий
		IDLE = false;
	else
		IDLE = true;

	if (HAL_GPIO_ReadPin(GPIOB, OD_IN_LIGHT_PB12_Pin) == GPIO_PIN_SET)
		//Обработка включенного OD. Нажата кнопка OD - высокий уровень. �?наче низкий
		AT_OD = true;
	else
		AT_OD = false;
}

void AdjustValue(uint8_t value, uint8_t action) {
	float input_value;
	switch (value) {
	case PID_P: {
		input_value = PID.Kp;
		if (action == UP)
			input_value += 1;
		else
			input_value -= 1;
		PID.Kp = input_value;
	}
		break;
	case PID_I: {
		input_value = PID.Ki;
		if (action == UP)
			input_value += 0.01;
		else
			input_value -= 0.01;
		PID.Ki = input_value;
	}
		break;
	case PID_D: {
		input_value = PID.Kd;
		if (action == UP)
			input_value += 0.01;
		else
			input_value -= 0.01;
		PID.Kd = input_value;
	}
		break;
	}
}

uint8_t ReadCruiseSwitch() {
	NewKeyValue = GetButtonNumberByValue(ADC_Data[Switch_Data]);
	//OldKeyValue 1
	//NewKeyValue 5
	//detectlongpress[1]=21
	//Поиск долгого нажатия клавиши, больше 2х секунд
	if (OldKeyValue == NewKeyValue && NewKeyValue != 5)
		detectlongpress[NewKeyValue] += 1;
	//Обработка нажатой клавиши в момент ее отпускания. Одновременно с проверкой на долгое нажатие.
	//const uint16_t values[5] = { 0, 374, 834, 1373, 2125 };
	if (OldKeyValue != NewKeyValue && NewKeyValue == 5) {
		switch (OldKeyValue) {
		case 1: {
			//кнопка ON-OFF
			//При нажатии на главном экране включается-отключается круиз
			//При нажатии на экране настроек переключается настраиваемый параметр.
			if (detectlongpress[OldKeyValue] > LONG_PRESS_DURATION) {
				//долгое нажание на ON-OFF
				if (screen == 0) {
					//долгое нажание на экране тюна пидов - сохранение их в еепром единоразово. После этого
					//возможность сохранения блокируется до тех пор пока не перейдешь на главный экран
					//с целью исключения износа EEPROM
					SaveToEEPROM();

				}
				detectlongpress[OldKeyValue] = 0;
				break;
			}
			OldKeyValue = NewKeyValue;
			if (CRUISE_ARMED && screen == 1)
				//отключение круиза
				disarm();
			else if (!CRUISE_ARMED && screen == 1) {
				//включение круиза
				arm();
			} else if (screen == 0) {
				//на экране настроек переключается настраиваемый параметр.
				if (EDITED_VALUE_NUM != PID_D)
					EDITED_VALUE_NUM++;
				else
					EDITED_VALUE_NUM = 0;
			}
		}
			break;
		case 2:       //RES
		{
			if (detectlongpress[OldKeyValue] > LONG_PRESS_DURATION) {
				//длинное нажание на RES
				detectlongpress[OldKeyValue] = 0;
			}
			OldKeyValue = NewKeyValue;
			if (CRUISE_ARMED && screen == 1)
				SPD_TARGET += 10;
			else if (screen == 0) {
				AdjustValue(EDITED_VALUE_NUM, UP);
			}
		}
			break;
		case 3:       //SET
		{
			if (detectlongpress[OldKeyValue] > LONG_PRESS_DURATION) {
				//длинное нажание на SET
				detectlongpress[OldKeyValue] = 0;
			}
			OldKeyValue = NewKeyValue;
			//На основном экране уменьшение желаемой скорости
			if (CRUISE_ARMED && screen == 1)
				SPD_TARGET -= 10;
			//на нулевом экране - коррекция текущего параметра вниз
			else if (screen == 0) {
				AdjustValue(EDITED_VALUE_NUM, DOWN);
			}
		}
			break;
		case 4:       //CANCEL
		{
			if (detectlongpress[OldKeyValue] > LONG_PRESS_DURATION) {
				//длинное нажание на cancel
				detectlongpress[OldKeyValue] = 0;
			}
			OldKeyValue = NewKeyValue;
			screen++;
			if (screen == 2)
				screen = 0;
			HAL_GPIO_TogglePin(PC13_GPIO_Port, PC13_Pin);
		}
			break;
		case 5:       //NO PRESSED
		{
			OldKeyValue = NewKeyValue;
		}
			break;
		}

	} else
		OldKeyValue = NewKeyValue;
	return OldKeyValue;
}

uint8_t u8x8_gpio_and_delay_mine(u8x8_t *u8x8, uint8_t msg, uint8_t arg_int,
		void *arg_ptr) {
	switch (msg) {
	case U8X8_MSG_GPIO_AND_DELAY_INIT:
		break;
	case U8X8_MSG_DELAY_NANO:
		break;
	case U8X8_MSG_DELAY_10MICRO:
		break;
	case U8X8_MSG_DELAY_100NANO:
		break;
	case U8X8_MSG_DELAY_MILLI:
		break;
	case U8X8_MSG_DELAY_I2C:
		break;
	case U8X8_MSG_GPIO_I2C_CLOCK:
		break;
	case U8X8_MSG_GPIO_I2C_DATA:
		break;
	default:
		break;
	}
	return 1;
}

uint8_t u8x8_byte_stm32f103_hw_i2c(U8X8_UNUSED u8x8_t *u8x8,
U8X8_UNUSED uint8_t msg, U8X8_UNUSED uint8_t arg_int,
U8X8_UNUSED void *arg_ptr) {
#define MAX_LEN 32
	static uint8_t vals[MAX_LEN];
	static uint8_t length = 0;
	U8X8_UNUSED uint8_t *args = arg_ptr;
	switch (msg) {
	case U8X8_MSG_BYTE_SEND: {
		if ((arg_int + length) <= MAX_LEN)
			for (int i = 0; i < arg_int; i++) {
				vals[length] = args[i];
				length++;
			}
		break;
	}
	case U8X8_MSG_BYTE_INIT:
		break;
	case U8X8_MSG_BYTE_SET_DC:
		break;
	case U8X8_MSG_BYTE_START_TRANSFER: {
		length = 0;
		break;
	}
	case U8X8_MSG_BYTE_END_TRANSFER: {
		while (HAL_I2C_GetState(&hi2c1) != HAL_I2C_STATE_READY) { /* empty */
		}
		const uint8_t addr = 0x78;
		HAL_I2C_Master_Transmit(&hi2c1, addr, vals, length, 10);
		amountsent += length;
		break;
	}
	default:
		return 0;
	}
	return 1;
}

void HAL_GPIO_EXTI_Callback(uint16_t GPIO_Pin)

{
	if (GPIO_Pin == GPIO_PIN_11) { //RPM
		rpm_ticks++;
	} else {
		__NOP();
	}

}
//todo: обороты были завышены в два раза
void CalculateRPM() {
	if (second == 10) {
		rpm = rpm_ticks * 40 / 2;
		second = 0;
		rpm_ticks = 0;
		pwm += 50;
		if (pwm > 1000)
			pwm = 0;
	}
}
void HAL_TIM_PeriodElapsedCallback(TIM_HandleTypeDef *htim) {
	if (htim->Instance == TIM1) {
		//прерывание каждые 100мс
		readGPIO();
		CheckCruiseAndDisarm(STP, AT_D, IDLE, rpm, SPD_CURRENT);
		readADC();
		ReadCruiseSwitch();
		ticktock++;
		second++;
		if (CRUISE_ARMED) {
			pid_error = SPD_CURRENT - SPD_TARGET;
			PID_OUT_CURRENT = (int) arm_pid_f32(&PID, pid_error);
			setMSpeed(PID_OUT_CURRENT);
		}
		pidloop = true;
		CalculateRPM();
	}
	if (htim->Instance == TIM3) {
		lowspeed = true; //если переполнился счетчик таймера спидометра - значит слишком медленная скорость
		SPD_Pulse_width = 0;
	}

}

void HAL_TIM_IC_CaptureCallback(TIM_HandleTypeDef *htim) {
	if (htim->Channel == HAL_TIM_ACTIVE_CHANNEL_1) // =RISING= EDGE DETECTED
		__HAL_TIM_SET_COUNTER(&htim3, 0x00);
	else if (htim->Channel == HAL_TIM_ACTIVE_CHANNEL_2) // =FALLING= EDGE DETECTED
		IC_Faling_Val = HAL_TIM_ReadCapturedValue(htim, TIM_CHANNEL_2);
}

void showpage(uint8_t page) {
	char tmp_string[6];
	switch (page) {
	case 0: {
		u8g2_FirstPage(&u8g2);
		do {
			u8g2_SetFont(&u8g2, u8g2_font_artossans8_8u);
			u8g2_DrawStr(&u8g2, 0, font_h, "P");
			u8g2_DrawStr(&u8g2, 0, font_h * 2, "I");
			u8g2_DrawStr(&u8g2, 0, font_h * 3, "D");
			u8g2_DrawStr(&u8g2, font_w, font_h * (EDITED_VALUE_NUM + 1), "->");
			ftoa(PID.Kp, tmp_string, 3);
			u8g2_DrawStr(&u8g2, font_w * 3, font_h, tmp_string);
			ftoa(PID.Ki, tmp_string, 3);
			u8g2_DrawStr(&u8g2, font_w * 3, font_h * 2, tmp_string);
			ftoa(PID.Kd, tmp_string, 3);
			u8g2_DrawStr(&u8g2, font_w * 3, font_h * 3, tmp_string);
		} while (u8g2_NextPage(&u8g2));
	}
		break;
	case 1: {
		EEPROM_RECENT_WRITE = false;
		u8g2_FirstPage(&u8g2);
		do {
			u8g2_SetFont(&u8g2, u8g2_font_artossans8_8u);
			u8g2_DrawStr(&u8g2, 0, font_h, "PID");
			u8g2_DrawStr(&u8g2, 0, font_h * 2, "CUR");
			u8g2_DrawStr(&u8g2, 0, font_h * 3, "TGT");
			u8g2_DrawStr(&u8g2, 0, font_h * 4, "IMP");
			u8g2_DrawStr(&u8g2, 0, font_h * 5, "RPM");
			u8g2_DrawStr(&u8g2, 0, font_h * 6, "STP");
			u8g2_DrawStr(&u8g2, 0, font_h * 7, "IDL");
			u8g2_DrawStr(&u8g2, 0, font_h * 8, "ATD");
			u8g2_DrawStr(&u8g2, font_w * 5, font_h * 6, "ATO");
			itoa(PID_OUT_CURRENT, tmp_string, 10);
			u8g2_DrawStr(&u8g2, font_w * 3, font_h, tmp_string);
			itoa((int) (SPD_CURRENT + 0.1), tmp_string, 10);
			u8g2_DrawStr(&u8g2, font_w * 3, font_h * 2, tmp_string);
			itoa((int) SPD_TARGET, tmp_string, 10);
			u8g2_DrawStr(&u8g2, font_w * 3, font_h * 3, tmp_string);
			itoa(IC_Faling_Val * 10, tmp_string, 10);
			u8g2_DrawStr(&u8g2, font_w * 3, font_h * 4, tmp_string);
			itoa(rpm, tmp_string, 10);
			u8g2_DrawStr(&u8g2, font_w * 3, font_h * 5, tmp_string);
			if (STP == true)
				u8g2_DrawBox(&u8g2, font_w * 3, font_h * 5, font_w, font_h);
			else
				u8g2_DrawFrame(&u8g2, font_w * 3, font_h * 5, font_w,
				font_h);
			if (IDLE == true)
				u8g2_DrawBox(&u8g2, font_w * 3, font_h * 6, font_w, font_h);
			else
				u8g2_DrawFrame(&u8g2, font_w * 3, font_h * 6, font_w,
				font_h);
			if (AT_D == true)
				u8g2_DrawBox(&u8g2, font_w * 3, font_h * 7, font_w, font_h);
			else
				u8g2_DrawFrame(&u8g2, font_w * 3, font_h * 7, font_w,
				font_h);
			if (AT_OD == true)
				u8g2_DrawBox(&u8g2, font_w * 8, font_h * 5, font_w, font_h);
			else
				u8g2_DrawFrame(&u8g2, font_w * 8, font_h * 5, font_w,
				font_h);
		} while (u8g2_NextPage(&u8g2));
	}
		break;
	default:
		break;
	}

}

/* USER CODE END 0 */

/**
  * @brief  The application entry point.
  * @retval int
  */
int main(void)
{
  /* MCU Configuration--------------------------------------------------------*/

  /* Reset of all peripherals, Initializes the Flash interface and the Systick. */
  HAL_Init();

  /* Configure the system clock */
  SystemClock_Config();

  /* Initialize all configured peripherals */
  MX_GPIO_Init();
  MX_ADC1_Init();
  MX_TIM1_Init();
  MX_TIM2_Init();
  MX_I2C1_Init();
  MX_TIM3_Init();
  /* USER CODE BEGIN 2 */
	HAL_TIM_Base_Start_IT(&htim1);
	HAL_TIM_IC_Start_IT(&htim3, TIM_CHANNEL_1);
	HAL_TIM_IC_Start_IT(&htim3, TIM_CHANNEL_2);
	HAL_TIM_PWM_Start(&htim2, TIM_CHANNEL_1);
	HAL_Delay(100); //задержка для стабилизации напряжения чтобы SSD1306 корректно стартовал
	u8g2_Setup_ssd1306_i2c_128x64_noname_1(&u8g2, U8G2_R0,
			u8x8_byte_stm32f103_hw_i2c, u8x8_gpio_and_delay_mine);
	u8g2_InitDisplay(&u8g2); // send init sequence to the display, display is in sleep mode after this,
	u8g2_SetPowerSave(&u8g2, 0); // wake up display

/*
	 EEPROM.PID_P=100;
	 EEPROM.PID_I=0.025;
	 EEPROM.PID_D=10;
	 uint8_t const * p = (uint8_t const *)&EEPROM;
	 for(size_t i = 0, len = sizeof(EEPROM); i < sizeof(EEPROM); i += EEPROM_BLOCK_SIZE, len -= EEPROM_BLOCK_SIZE) {
	 HAL_I2C_Mem_Write(&hi2c1, devAddr, i, I2C_MEMADD_SIZE_16BIT, p + i, (len > EEPROM_BLOCK_SIZE) ? EEPROM_BLOCK_SIZE : len, 1);
	 HAL_Delay(5);
	 }
*/
	EEPROM.PID_P = 0;
	EEPROM.PID_I = 0;
	EEPROM.PID_D = 0;
	uint8_t * r = (uint8_t*) &EEPROM;
	for (size_t i = 0, len = sizeof(EEPROM); i < sizeof(EEPROM); i +=
	EEPROM_BLOCK_SIZE, len -= EEPROM_BLOCK_SIZE) {
		HAL_I2C_Mem_Read(&hi2c1, devAddr, i, I2C_MEMADD_SIZE_16BIT, r + i,
				(len > EEPROM_BLOCK_SIZE) ? EEPROM_BLOCK_SIZE : len, 1);
	}

	PID.Kp = EEPROM.PID_P; /* Proporcional */
	PID.Ki = EEPROM.PID_I; /* Integral */
	PID.Kd = EEPROM.PID_D; /* Derivative */

	arm_pid_init_f32(&PID, 1);
	for (uint8_t i = 0; i < 4; i++)
		detectlongpress[i] = 0;
  /* USER CODE END 2 */

  /* Infinite loop */
  /* USER CODE BEGIN WHILE */

	while (1) {
		SPD_Pulse_width = IC_Faling_Val * 10;
		if (SPD_Pulse_width > 300000 || SPD_Pulse_width < 1000) {
			lowspeed = true;
			SPD_Pulse_width = 0;
			SPD_CURRENT = 0;
		} else {
			SPD_CURRENT = 600.0 / (SPD_Pulse_width / 1000.0);
			lowspeed = false;
		}

		/*if (CRUISE_ARMED && pidloop) {
		 pid_error = SPD_CURRENT - SPD_TARGET;
		 PID_OUT_CURRENT = (int) arm_pid_f32(&PID, pid_error);
		 if (PID_OUT_CURRENT != PID_OUT_PREVIOUS) {
		 setMSpeed(PID_OUT_CURRENT);
		 PID_OUT_PREVIOUS = PID_OUT_CURRENT;
		 }
		 pidloop = false;
		 }
		 */
		if (ticktock >= 4) {
			showpage(screen);
			ticktock = 0;

		}

    /* USER CODE END WHILE */

    /* USER CODE BEGIN 3 */
	}
  /* USER CODE END 3 */
}

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
