hyperion11/CruiseToyotaPradoStm32/STM32CubeMX/Cruise.ioc

Mcu.UserName=STM32F103C8Tx
PA0-WKUP.GPIO_Label=VNH2_SP30_PWM
PA0-WKUP.Signal=S_TIM2_CH1_ETR
PA10.Signal=USART1_RX
PA13.Signal=SYS_JTMS-SWDIO
PA14.Signal=SYS_JTCK-SWCLK
PA3.GPIO_Label=STOP_IN_PA3
PA3.Signal=GPIO_Input
PA8.GPIO_Label=D_IN_PA8
PA8.Signal=GPIO_Input
PA9.Signal=USART1_TX
PB0.GPIO_Label=TPS_ADC
PB0.Signal=ADCx_IN8
PB1.GPIO_Label=SWITCH_ADC
PB1.Signal=ADCx_IN9
PB10.GPIO_Label=PB10_OUT_SOLENOID
PB10.Signal=GPIO_Output
PB11.GPIO_Label=RPM_EXTI11
PB11.Signal=GPXTI11
PB12.GPIO_Label=OD_IN_LIGHT_PB12
PB12.Signal=GPIO_Input
PB13.GPIO_Label=OD_OUT_BUTTON_PB13
PB13.Signal=GPIO_Output
PB14.GPIO_Label=IDLE_IN_PB14
PB14.Signal=GPIO_Input
PB15.GPIO_Label=CRUISE_LAMP_OUT_PB15
PB15.Signal=GPIO_Output
PB4.GPIO_Label=TIM3_CH2_SPD
PB4.Signal=S_TIM3_CH1
PB5.GPIO_Label=TB6612FNG_STB
PB5.Signal=GPIO_Output
PB6.Signal=I2C1_SCL
PB7.Signal=I2C1_SDA
PB8.GPIO_Label=VNH2_SP30_INA
PB8.Signal=GPIO_Output
PB9.GPIO_Label=VNH2_SP30_INB
PB9.Signal=GPIO_Output
PC13-TAMPER-RTC.GPIO_Label=PC13
PC13-TAMPER-RTC.Signal=GPIO_Output
PD0-OSC_IN.Signal=RCC_OSC_IN
PD1-OSC_OUT.Signal=RCC_OSC_OUT
