hyperion11/CruiseToyotaPradoStm32/(commit log)

2018-12-29 попробовал добавить второй таймер
2018-12-30 move to stm32cubemx and atollic
2019-01-01 Добавлен i2c экран SSD 1306
2019-01-01 генератор -эмулятор импульсов для тахометра и спидометра добавлен
    на ардуино уно основан
2019-01-01 добавлен LCD Дисплей и генерация частот тахометра и спидометра
2019-01-02 Доделан тестовый генератор
    На экран выводится скорость, обороты.
    А также длительность импульса скорости и оборотов
2019-01-03 сделан тахометр спидометр, убрал USB
2019-01-05 Добавлен PID
2019-01-06 добавлен EEPROM 24C04
2019-01-07 начата работа над схемой
    [cruise.brd, cruise.sch]
2019-01-09 ADC, arm, disarm
    Чтение 3х каналов ADC через DMA (надо проверить)
    arm, disarm круиза
    [cruise.sch]
2019-01-09 инжектированные каналы вместо ДМА
    + фикс багов
2019-01-10 чистка и оптимизация
2019-01-10 работа над схемой
    [cruise.brd, cruise.sch]
2019-01-10 оптимизация чтения скорости
    + переделанный диагностический экран
2019-01-14 схема
    [cruise.brd, cruise.sch]
2019-01-14 +pdf схема
2019-01-20 схема+проверка работы мотора
    какой то косяк с шимом. Наверное зря удалил подтягивающий резистор. Нормально работает только на частоте до 1кгц
    [cruise.brd, cruise.sch, Книга1.xlsx]
2019-01-21 PWM+PID
    Заработал нормально Pwm 20khz
    Заработал вменяемо PID
    [cruise.brd, cruise.sch, mosfetcalc.xlsx, Книга1.xlsx]
2019-01-23 добавлен функционал тюна пидов
    [cruise.brd, cruise.sch]
2019-01-23 фикс тюна пидов
2019-02-24 измененние схемы
    [cruise.brd, cruise.sch]
2019-02-25 работа со схемой
    [cruise.brd, cruise.sch]
2019-02-26 еще схема
    [cruise.brd, cruise.sch]
2019-04-09 drivers added
2019-04-12 bluepill version added
    [cruise.brd, cruise.csv, cruise.sch]
2019-04-12 фикс adc
2019-05-28 перешел на PCB версию
    1. добавил задержку для инициализации экрана
    2. вернул назад таймеры для внешнего кристалла
    todo:
    проверить работу драйвера мотора. Светодиоды не светятся почему то.
