hyperion11/CruiseToyotaPradoStm32/(notices)

Notices in the files:
STM32CubeMX/Src/main.c:
Copyright (c) 2018 STMicroelectronics International N.V.
All rights reserved.
(C) COPYRIGHT STMicroelectronics *****END OF FILE
parts and their libraries:
m-pad-2.1: License : GNU General Public License version 2 (see bottom)
crystal-geyer_V1_0: Copyright: Geyer-Electronic
